11grace17/I-Robocom/other/Final (Programming 2).jpg

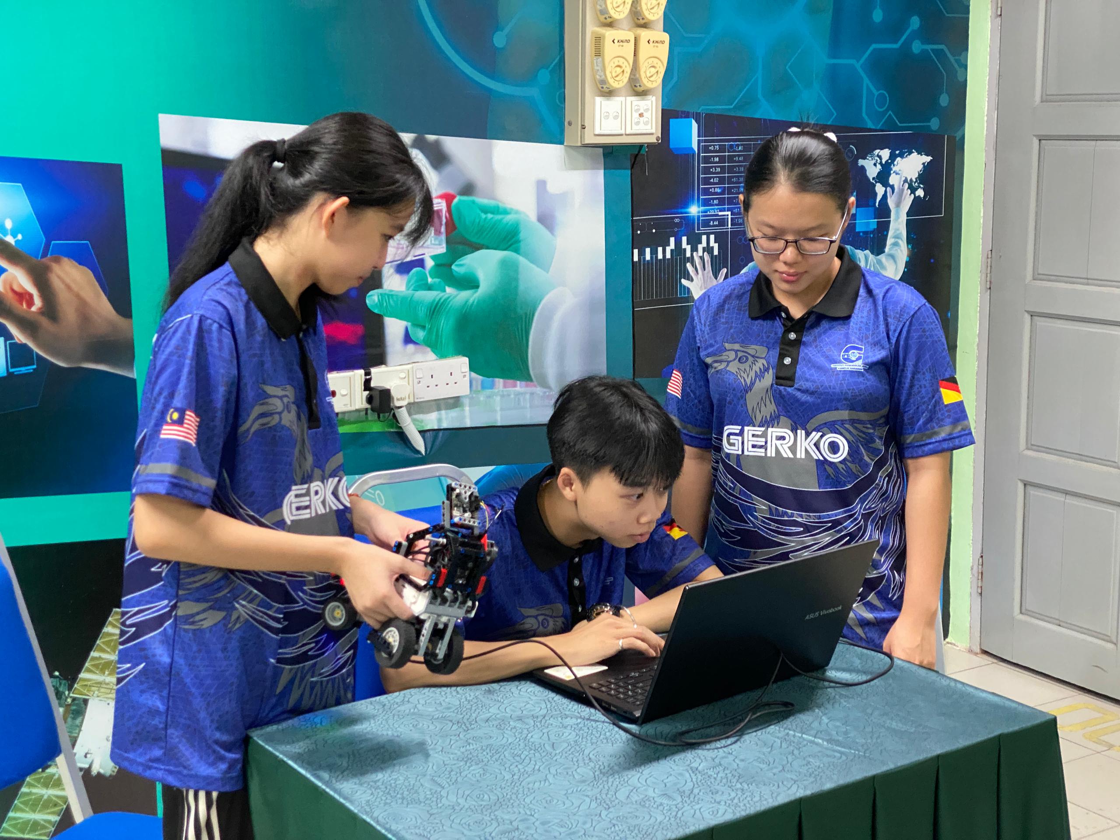
other/Final (Programming 2).jpg
