11grace17/I-Robocom/v-photos/top view.jpg

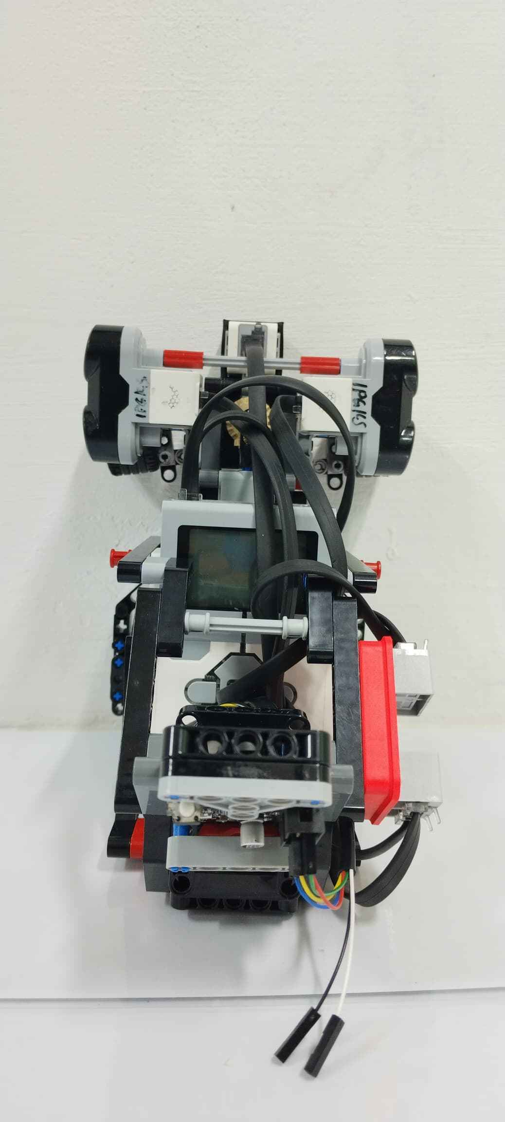
v-photos/top view.jpg
