11grace17/I-Robocom/README.md

# Introduction
This engineer’s documentation comprises engineering materials of the autonomous vehicle robot’s model, designed for participation in the WRO International Final 2024 Future Engineers Competition.

# Content
**schemes** This folder contains one or several schematic diagrams in the form of JPEG, PNG, or PDF of the electromechanical components illustrating all the elements (electronic components and motors) used in the vehicle and how they connect.

**src** This folder contains all the programming flowcharts and all programming used to participate in the WRO 2024 Future Engineers Category.

**pictures-team & vehicle** This folder contains photos of the team participating in the WRO, photos of the vehicle (from all sides and bottom views) and photo shown in documentation.

**video** This folder contains video.md file that demonstrates how the robot functions to solve both tasks.

**models** This folder contains the 3D design of the vehicle in .lxf and the rendered model of the vehicle.

**other** This folder contains other files which can be used to understand how to prepare the vehicle for the competition.

# I-Robocom Team, Malaysia
Our team is composed of three dedicated members who meticulously oversee the critical aspects of our autonomous vehicle's construction. Introducing Team I-Robocom from Malaysia - a passionate group devoted to refining the essential electromechanical components that power our fully autonomous vehicle. Let’s meet our team members: 

**Nelson Soo Hui Leng, Chang Pei Ru, and Grace Tan Hong Hui.**


# Performance video
This video provides an in-depth look at the structure of our self-driving car, a demonstration of its performance in both the Open Challenge and Obstacles Challenge, and a detailed explanation of how the car operates within each challenge. Please click the link https://youtu.be/7t6WDGnzcJU or scan the QR code to watch the video and explore our project in action.



# 1.0 Mobility management
This section provides an overview of the self-driving car’s design, detailing how its movement is controlled, along with the types of motors used and its implementation to the car. It includes a summary of the car’s chassis design and how various components are mounted on the structure. Additionally, key engineering principles such as speed, torque, and power are discussed.

## 1.1 Design of the self-driving car
The autonomous self-driving car is constructed using the Lego 45544 Mindstorms EV3 Education Set.


## 1.2  Chassis of the self-driving car
The design of the self-driving car’s chassis plays a crucial role in providing structural support, which ensures the car remains stable during fast movements like sharp turns and rapid accelerations. Therefore, our self-driving car is designed based on the concept of the right selection of the tyre, the implementation of motors, the implementation of differential gear and the engineering principle of the steering.

**(i) Selection of tyre**

We chose the LEGO 32019 rim and 86652 wheels because it provides a strong grip on different surfaces, reducing slipping and improving stability. It allows our self-driving car to move in a stable way while encountering both Open Challenge and Obstacle Challenge.



**(ii) Implementation of motor and its engineering principle**

We use two EV3 Medium Motors to move the self-driving car forward and backwards. Placing them side by side horizontally or laterally to save space and make the car more compact. This setup also makes it easier to arrange the reduction gears and keeps the centre of gravity low, which improves stability during high-speed movement during the Open Challenge.



The diagram below shows the details of the EV3 Medium Motor. 

The EV3 Medium Motor is implemented due to its quick reactions and precise movements. As we can see from the diagram above, the running torque of 8Ncm and a stalled torque of 15 Ncm allow the self-driving car to handle the moderate forces that are needed for the steering, where small adjustments are needed. Moreover, the EV3 Medium Motor also provide us with a speed of 260 rpm, which means it can rotate quickly, making it ideal for rapid changes in direction or fine adjustments while avoiding traffic signs.

 **(iii) Implementation of differential gear**
 
The differential gear distributes power between two axles, allowing them to rotate at different speeds. This helps the self-driving car make smooth turns, especially when navigating corners of the inner walls.



**(iv) Engineering principle of steering**

Our self-driving car’s front steering uses a gear-down system, which slows down the turning motion for better control and precision in small rotations. This is helpful during making smooth and precise turns to avoid traffic signs.



We also use Ackermann steering geometry, which gives each front wheel a slightly different angle when turning. This setup allows the inner and outer tyres to follow separate paths, reducing tyre slip and friction. By keeping the tyres at the optimal angle, this design improves stability and reduces tyre wear, helping the robot make sharp turns without sliding or tipping.



## 1.3 Building of the self-driving car

In this section, the building instruction of the self-driving car and the video of the 3D printing parts process can be obtained through the link or QR Code below. 

**Robot Building Instruction**

https://github.com/11grace17/I-Robocom/blob/main/models/I-Robocom%20Building%20Instruction.pdf 



**3D parts printing process**

https://youtu.be/nPkDxdlI2Hc



# 2.0	Power and sense management

This section will discuss the self-driving car’s power source and the sensors required to provide the car with information to negotiate the different challenges. The discussion included the reasons for selecting various sensors and how they are being used on the car together with power consumption. The Build of Materials (BOM) and wiring diagram are also provided.

## 2.1 Power source

We’ve boosted our self-driving car’s energy with the Soshine Rechargeable AA Lithium-ion Battery, providing 1.5V and 2600mWh of power to keep it running smoothly. This battery is the key source of energy for our robot.



## 2.2 Sensor

The self-driving car is equipped with a color sensor, two ultrasonic sensors, a gyro sensor and two Pixy 2 cameras. This powerful combination allows our self-driving car to encounter both Open and Obstacle Challenges. The diagram below shows the summary of the sensors that our self-driving car used.



**(i) Pixy2 camera** 

Two Pixy2 cameras are used to assist our self-driving car. The Pixy2 camera will enable the self-driving car to identify multiple traffic signs at once while in motion. It will also be utilized for tasks like detecting walls and following lines on a map.



**(ii) Gyro sensor**

One gyro sensor is used to assist our self-driving car. The gyro sensor will help the self-driving car to calculate the angle and allow it to follow the correct orientation.



We initially used a compass sensor but switched to a gyro sensor due to interference from the self-driving car’s electromagnetic field, which affected compass accuracy. The LEGO EV3 gyro sensor effectively measures the self-driving car’s rotation angle, tracking tilt and rotational speed to maintain stable orientation and prevent drifting during turns. Although the EV3 gyro sensor can occasionally show an error on startup due to calibration issues, we had solved this issue by performing a hard reset each time the self-driving car is run, ensuring consistent accuracy in directional measurements.

**(iii) Ultrasonic sensor**

Two EV3 ultrasonic sensors are used to assist the self-driving car. The EV3 ultrasonic sensor is a digital device that measures the distance between the sensor and an object located in its path.



We originally used a Pixy2 camera to detect the walls, but due to frequent latency issues, we ended up switching to an ultrasonic sensor because it was able to read the required data faster and more directly. For both the open challenge and obstacle challenge, we chose to incorporate an ultrasonic sensor that measures the self-driving car’s distance from walls and detects corners. The sensor works by emitting sound waves and calculating the time it takes for them to return after hitting the wall. With this information, our self-driving car will be able to navigate effectively and make accurate turns, with the main goal of finishing the open challenge as quickly as possible.

**(iv) Color sensor**

One color sensor is only used in the obstacle challenge. It is used to determine when the self-driving car should turn. For a clockwise direction, the car will turn left every time it detects an orange line. Conversely, the robot will turn right when the color sensor detects a blue line in the counterclockwise direction. It works by measuring the intensity of the light that enters the sensor. The car uses the color sensor to determine whether the robot runs in a clockwise direction or counterclockwise direction by detecting the color line.



## 2.3 Build of materials

Below is the Build Of Material (BOM) that is used to build the self-driving car and ensure each component aligned together with the self-driving car's functional needs.

















## 2.4 Wiring diagram

The wiring diagram below shows the power consumption of the sensors and how the motors and sensors are connected to our self-driving car to support both the open challenge and obstacle challenge setups.

**(i) Open challenge wiring diagram**



**(ii) Obstacle challenge wiring diagram**



# 3.0 Obstacle management

In our project, we utilize the Clev3r-Python programming language to operate the self-driving car. The programming structure is divided into two main sections: the Open Challenge and the Obstacle Challenge. This segment includes a flowchart and an overview of the code used for both challenges. Each part of the program is designed to meet specific requirements and optimize the self-driving car’s performance in different scenarios, providing a clear understanding of how the self-driving car functions under distinct conditions.

## 3.1 Open challenge

The left and right ultrasonic sensors help the self-driving car determine its direction, whether it is moving clockwise or counterclockwise. These sensors detect the distance between the self-driving car and nearby walls, allowing the car to adjust its steering mechanism to avoid collisions. When an ultrasonic sensor reaches a certain threshold, indicating the absence of a wall, the car will turn accordingly. Additionally, the gyro sensor ensures that the car maintains a straight path and makes precise turns when necessary.
The diagram below shows the flowchart for the Open Challenge.



Below are the explanation for the Open Challenge programming:



The code snippet appears to set up a project in a folder named "prjs" with the title "Clever." Additionally, it sets the mode for two sensors (Sensor 1 and Sensor 3) to mode 0, which are preparing them for a basic operation and specific function.



The waitDegrees function pauses the program until motor D rotates a specified number of degrees. It records the initial degree count of motor D and enters a loop that continues until the difference between the current count and the initial count reaches the desired degree threshold. During this wait, it repeatedly calls the Steering function to maintain the self-driving car’s steering. 



The setSensorMode function sets up a multiplexer sensor by choosing the port, channel and mode. It calculates the I2C address for the channel and sends a command to set the sensor’s mode. This allows the self-driving car to adapt the sensor's functionality according to the requirements of the task.



The function getValue takes three parameters: port, channel, and values. It calculates the I2C address for the specified channel by adding 80 to the channel number (adjusted by subtracting 1). The function then reads two registers from the sensor using the Sensor.ReadI2CRegisters, starting at the calculated address. It combines the two bytes of data to compute a single value, which is assigned to the values output parameter. Finally, it clears the LCD display and shows the values at the specified position on the screen.



This code snippet initializes several variables and configures sensors for a self-driving car’s movement. It sets values such as target, loopCount, cw, gyroLastError, and wallError to zero, which likely represents the target value, loop iteration count, a clockwise direction indicator, and error values for gyro and wall sensors, respectively.
The setSensorMode function is called to configure two sensors on port 2, with channels 1 and 2, both set to mode 0, possibly for basic functionality. After that, the getValue function retrieves distance readings from the left and right sensors (channels 1 and 2) and assigns these values to the variables leftDistance and rightDistance. This setup is likely part of a control loop for a robot to navigate based on distance measurements from its surroundings.



The ResetSteering subroutine reset motor A. It starts the motor at 50% power for 500 milliseconds, then waits until the motor stops. Afterwards, it moves the motor backwards at -50% speed for 110 degrees and finally resets the motor's position count. The Motor. The move function specifies the motor port, speed, rotation degrees, and brake mode.





The subroutine Steering calculates the steering adjustments for a self-driving car based on its relative heading and wall distances. It first reads the raw value from sensor 3, adjusts it by negating it and adding a target value to get relativeHeading. If the absolute value of relativeHeading is less than 20 and loopCount is greater than 0, it checks if the self-driving car is moving clockwise (cw = 1). Depending on the direction, it retrieves the right or left distance using getValue, updating the Wall variable if the distance is less than 2500.

The subroutine then computes a gyro correction based on the relativeHeading and its previous error and a wall correction based on the distance to the wall. These corrections are combined to determine the steering adjustment and turn. If the condition is not met, it turns to a scaled version of relativeHeading. Finally, it calculates the power for the medium motor by adjusting the steering power based on the difference between the calculated turn and the motor count and activates the motor with Motor.StartPower("A", steeringPower).



The code snippet starts by activating motor "D" at 75% power using Motor.StartPower("D", 75). It then retrieves distance measurements from two sensors: it calls getValue(2, 1, leftDistance) to get the left distance and getValue(2, 2, rightDistance) to get the right distance. This setup is likely part of a control mechanism for navigating or avoiding obstacles based on the distances measured by the sensors.





The code snippet initiates a loop that runs while loopCount is less than 12. In the first iteration (loopCount = 0), it waits for the motor to rotate 150 degrees with waitDegrees(150) and enters a nested loop that continuously retrieves left and right distance measurements until both distances are less than 1800. Within this loop, it calls the Steering() function to adjust the self-driving car’s direction. Afterwards checks if the right distance exceeds 1800; if so, it sets cw to 1 (indicating a clockwise direction), otherwise, it sets cw to -1. 

For subsequent iterations, it waits for the motor to rotate 1300 degrees, and based on the current value of cw, it enters another nested loop that keeps calling Steering() while either the left or right distance is less than 1800. After each iteration, it adjusts the target by subtracting 91 multiplied by cw and increments loopCount. It also plays a tone using the speaker.

After the loop concludes, the code waits for the motor to rotate 1250 degrees, and then it enters an infinite loop that stops motor "D" with Motor.Stop("D", "True").

## 3.2	Obstacle challenge

The upper Pixy2 camera detects traffic signs. If it detects a red traffic sign, the self-driving car’s steering will turn right; if it detects a green traffic sign, the self-driving car will respond similarly with the specified action for green. The bottom color sensor helps the self-driving car follow the colored lines on the map. If it detects an orange line first, the self-driving car will turn clockwise; if it detects a blue line first, it will turn counterclockwise.

The rear Pixy2 camera assists with U-turn decisions. When it detects a red signal, the self-driving car performs a U-turn; if it detects green, the self-driving car continues completing three normal laps. The gyro sensor maintains its primary role of ensuring the self-driving car travels in a straight line and executes precise turns.

The diagram below shows the flowchart for the Obstacle Challenge:



Below shows the explanation of the programming for the obstacle challenge. 



Folder creation, the code is creating or using a folder named "Clever" in the EV3's projects area. The color sensor connected to Port 4 is being set to detect colors. 



“Function Display (in number value1, in number value2)” is a function called Display that takes two input numbers, value1 and value2. “LCD. Clear ()” is used to clear the EV3's LCD screen to make sure there is no previous content displayed. The brackets LCD. Text (1,50,0,2, value1) represents the colors, x, y, font and text respectively. 



The setSensorMode function configures a multiplexer sensor by specifying the communication port, channel number, and desired mode. It calculates the I2C address based on the channel and sends a command to the sensor to set the specified mode using the Sensor.WriteI2CRegister function. This allows the robot to adapt the sensor's functionality according to the requirements of the task.



The getValue function reads the value from a multiplexer sensor connected to a specified port and channel on the EV3. It calculates the I2C address based on the channel, retrieves two bytes of data from the sensor, and combines these bytes to create a single sensor value, which is stored in the output variable values.



The getSignature function retrieves the x and y coordinates of an object detected by the Pixy camera on a specified port using a given signature. It calculates the I2C address with 80 + sig, reads 5 bytes of data from the Pixy camera, and assigns the x and y coordinates from the data to the x and y output variables.



The sensor function initializes the relative heading to zero, indicating no gyro error. It then sets the modes for three channels of the multiplexer sensor on port 2 to mode 0 using the setSensorMode function. This prepares the sensors for operation by configuring them to read data correctly for the robot's tasks.



The code defines a sensor function that continuously reads values from a gyro and wall sensors on the EV3. It sets the sensor modes for multiple channels and enters a loop in the ReadSensor subroutine. Inside this loop, it retrieves the raw gyro value and adjusts it to account for gyro errors, calculating the relative heading. It also reads values for the left and right walls and retrieves color signature values for different colors. The ReadSensor subroutine runs as a separate thread, allowing multitasking while reading sensor data.



The ResetSteering subroutine controls motor A to reset its position. It starts the motor at 50% power for 500 milliseconds, then waits until the motor stops. Afterwards, it moves the motor backwards at -50% speed for 105 degrees and finally resets the motor's position count. The Motor.Move function specifies the motor port, speed, rotation degrees, and brake mode.



The code defines variables for the self-driving car’s navigation: target sets the self-driving car’s heading direction to 0, lastPillar stores the last detected pillar, followRed and followGreen determine the distances to follow red and green pillars (200 and 220 units, respectively), and avoidRed and avoidGreen set the distances to avoid red and green pillars (10 and 5 units less than their following distances). These variables guide the car's movement in relation to the pillars it encounters.











In the Loop Functions, several variables are initialized to manage the car's operation, including speed, loop counts, and wall checks. The car assesses colors using the getSignature function to determine its last detected colors. If the last red object's y-coordinate is greater than that of the last green object, it prepares for a U-turn based on the detected colors. The main loop runs until loopCount reaches the predefined round. 

During the first section, it resets steering, waits for specific degrees, and reacts to color sensor readings, adjusting its direction accordingly. If a U-turn is needed after the eighth iteration, it modifies its target angle and waits before continuing. Finally, parking degrees are calculated based on the last detected pillar's color, and the car manoeuvres its parking position while adjusting for color detection.

# 4.0 Engineering factor

This section includes our design for the own manufacturing part and components. Moreover, this section also includes an explanation of the third-party element that is installed in the self-driving car.
 
  Our autonomous self-driving car is built mainly from the Lego 45544 Mindstorms EV3 Education Set. In addition, we have also installed a 3ʳᵈ party sensor, the Pixy 2 camera, and incorporated a 3D printing component. We had created a casing for the color sensor by using the 3D printer. The primary purpose of the components is to prevent the external light from interfering with its color detection. Additionally, the casing serves to protect the sensor in case of impact or collision.



# 5.0 Improvements

In this section, we outline the challenges encountered during the development of our self-driving car and the alternative approaches we adopted to enhance its performance. Through careful analysis of each obstacle, we identified and implemented improvements that have optimized the car's functionality, making it more reliable and efficient.

**(i)	Replace the compass sensor with the gyro sensor**



We initially used a compass sensor but ultimately switched to a gyro sensor. This decision was made because the wiring and electric motor in the device generate a strong electromagnetic field, which can interfere with the compass sensor and result in inaccurate readings. To address this issue, we ultimately decided to use a gyro sensor instead. The gyro sensor was chosen because it is less susceptible to electromagnetic interference from the device’s components, unlike the compass sensor. This allows the car to maintain consistent orientation and movement without disruptions from nearby magnetic fields.

**(ii) Implementing a multiplexer to solve the limited EV3 ports issue**



We also faced issue where we have only limited EV3 ports. Therefore, a multiplexer is used to solve this issue. The multiplexer allowed us to expand the number of available ports, enabling us to connect additional sensors and components to the EV3 without being limited by the device's built-in ports.

**(iii)	Replace 44771-062225 wheels to 32019+86652 wheels**



We started with the LEGO 44771 - 6062225 wheels but switched to the smaller LEGO 32019+86652 wheels. The smaller size makes it easier for the car to turn and park, improving its maneuverability and handling in tight spaces.

# Credits

We sincerely thank LEGO Education for their valuable support and dedication in supporting us with a high-quality LEGO EV3 set. Appreciation to the team sponsors from Ministry of Education Innovation and Talent Development Sarawak (MEITD);  SOP Foundation and YB Dato Sri Lee Kim Shin.
