11grace17/I-Robocom/src/I-Robocom open challenge flow chart.png

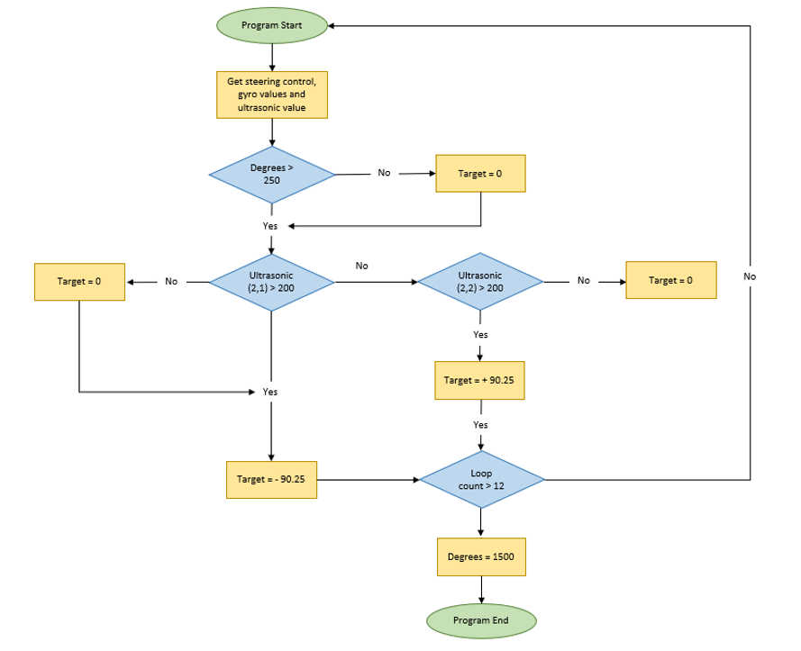
src/I-Robocom open challenge flow chart.png
