11grace17/I-Robocom/models/I-Robocom Color Sensor Casing.stl

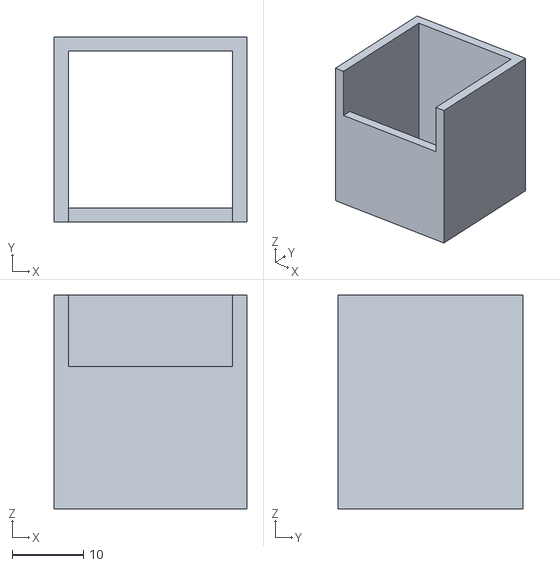
[picture p4: CAD file, 2024-11-17]
models/I-Robocom Color Sensor Casing.stl
27.0 x 26.0 x 30.0
